chipiotembedded/ABHAY-PRODUCT/Hardware/Receiver/BOM/CPV0001_BOM.xlsx

CPV0001 - BOM
Reference | Value | Footprint | QTY | Price (1 pc) IN RS
C1 | 22uF | Capacitor_SMD:C_0805_2012Metric_Pad1.18x1.45mm_HandSolder | 1 | 1
C2, C3, C4, C6, C8, C9, C10, C11, C12, C13,C14 | 0.1uF | Capacitor_SMD:C_0603_1608Metric_Pad1.08x0.95mm_HandSolder | 11 | 0.35
C5, C7 | 10uF | Capacitor_SMD:C_0805_2012Metric_Pad1.18x1.45mm_HandSolder | 2 | 1.5
D1 | G_LED | LED_SMD:LED_0805_2012Metric_Pad1.15x1.40mm_HandSolder | 1 | 1
J1 | USB Type A Right Angle Female Connector | Connector_USB:USB_A_Molex_67643_Horizontal | 1 | 5
J2 | UFL MALE CONNECTOR SMD | ufl:HRS_U.FL-R-SMT_01_ | 1 | 10
 | 2.4 GHZ/3 DB AT 5 GHZ SMA MALE RUBBER DUCK WIFI FOLDING ANTENNA-105 MM |  | 1 | 55
 | SMA FEMALE TO UFL ANTENNA EXT -200MM |  | 1 | 35
J3 | VIN BAT (screw terminal ) | TerminalBlock:TerminalBlock_bornier-2_P5.08mm | 1 | 3
J4 | Boot Button (burgstrips ) | Connector_PinHeader_2.54mm:PinHeader_1x02_P2.54mm_Vertical | 1 | 5
J5 | I2C (Pin 2.54 mm Pitch Male Berg Strip Straight Single Row Header 15 mm Height Gold Plated) | Connector_PinHeader_2.54mm:PinHeader_1x04_P2.54mm_Vertical | 1 | 10
J6 | BUZZER (screw terminal ) | TerminalBlock:TerminalBlock_bornier-2_P5.08mm | 1 | 3
J7 | FLASHER (screw terminal ) | TerminalBlock:TerminalBlock_bornier-2_P5.08mm | 1 | 3
J8 | UART (Code_Flasher (burgstrips )) | Connector_PinSocket_2.54mm:PinSocket_1x04_P2.54mm_Vertical | 1 | 5
R1 | 0 ohm (Resistor) | Resistor_SMD:R_0805_2012Metric_Pad1.20x1.40mm_HandSolder | 1 | 0.5
R2 | 10k (Resistor) | Resistor_SMD:R_0805_2012Metric_Pad1.20x1.40mm_HandSolder | 1 | 0.5
R3 | 330E (Resistor) | Resistor_SMD:R_0805_2012Metric_Pad1.20x1.40mm_HandSolder | 1 | 0.5
SW1 | SW_Push | Button_Switch_THT:SW_PUSH_6mm_H7.3mm | 1 | 3
SW2.SW3,SW4,SW5,SW6,SW7 | NUM_1,NUM_2,UP,BACK,NEXT,SILANCE | Button_Switch_THT:SW_PUSH-12mm , 12 x 12 x 20 mm Momentary Tactile Switch 4 Pin DIP Black ROHS | 6 | 10
U1 | ESP32-S3-WROOM-1-N16R8 | esp3 s3:ESP32-S3-WROOM-1_EXP | 1 | 356
U2 | RFM95W-868S2 (lora module ) | RF_Module:Ai-Thinker-Ra-01-LoRa | 1 | 500
U3 | LM1117DT-3.3 (regulator ) | Package_TO_SOT_SMD:TO-252-3_TabPin2 | 1 | 5
Adapter | 5 v |  | 1 | 150
METAL SPACERS THREADED MS-10 | 10MM |  |  | 5
POWER Jack | 2.1x5.5mm DC Power Jack Socket Panel Mount (Female) - |  | 1 | 10
cable gland | Polyamide Cable Gland PG 9 |  | 1 | 20
Enclosure metel box with screw |  |  | 1 | 500
16X 4 LCD | 16X4 GREEN LCD JHD Make |  | 1 | 315
 |  | Manufacturing cost (PCB) |  | 1200
 |  | Total |  | 3213.35
