chipiotembedded/ABHAY-PRODUCT/Enclosure/3D_box_new_Latest.iges

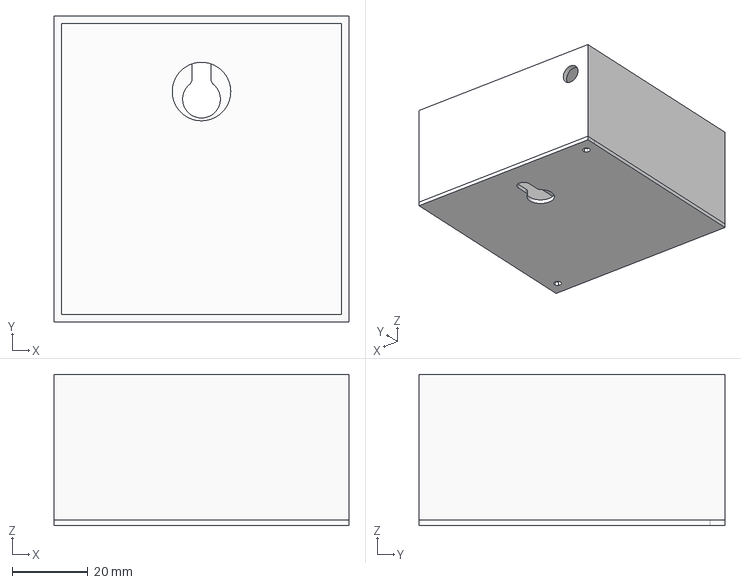
[picture p1: CAD file, 2026-10-03]
Enclosure/3D_box_new_Latest.iges
78.0 x 81.0 x 40.0 mm
