chipiotembedded/ABHAY-PRODUCT/Hardware/Receiver/kicad/reciever-.kicad_pcb

## KiCad design Hardware/Receiver/kicad/reciever-.kicad_pcb (2026-10-03)

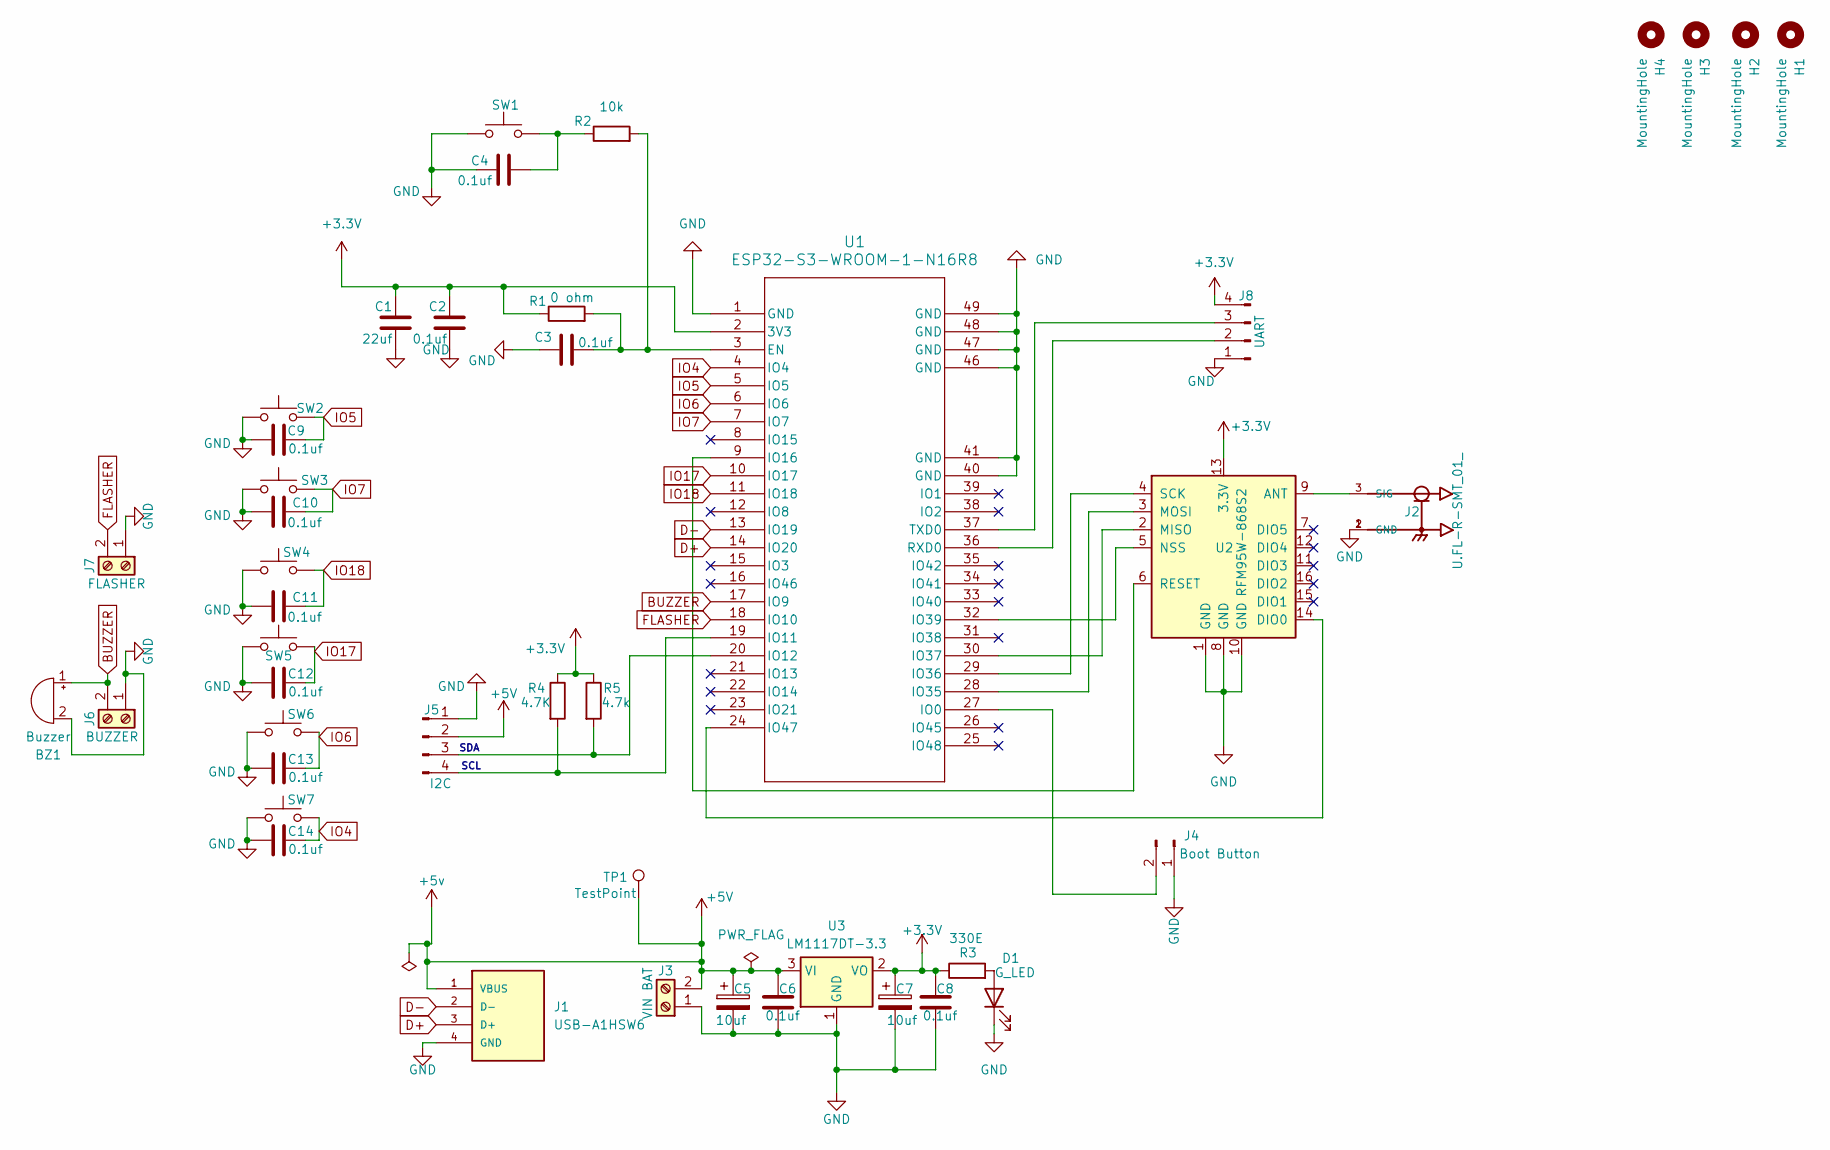
[picture p2: schematic reciever-.kicad_sch]

Parts:
BZ1: Buzzer; Buzzer_TDK_PS1240P02BT_D12.2mm_H6.5mm
C1: 22uf; C_0805_2012Metric_Pad1.18x1.45mm_HandSolder
C2, C3, C4, C6, C8, C9, C10, C11, C12, C13, C14: 0.1uf; C_0603_1608Metric_Pad1.08x0.95mm_HandSolder
C5, C7: 10uf; C_0805_2012Metric_Pad1.18x1.45mm_HandSolder
D1: G_LED; LED_0805_2012Metric_Pad1.15x1.40mm_HandSolder
H1, H2, H3, H4: MountingHole; MountingHole_3.5mm_Pad
J1: USB-A1HSW6; USB_A_Molex_67643_Horizontal
J2: U.FL-R-SMT_01_; HRS_U.FL-R-SMT_01_
J3: VIN BAT; TerminalBlock_bornier-2_P5.08mm
J4: Boot Button; PinHeader_1x02_P2.54mm_Vertical
J5: I2C; PinHeader_1x04_P2.54mm_Vertical
J6: BUZZER; TerminalBlock_bornier-2_P5.08mm
J7: FLASHER; TerminalBlock_bornier-2_P5.08mm
J8: UART; PinSocket_1x04_P2.54mm_Vertical
R1: 0 ohm; R_0805_2012Metric_Pad1.20x1.40mm_HandSolder
R2: 10k; R_0805_2012Metric_Pad1.20x1.40mm_HandSolder
R3: 330E; R_0805_2012Metric_Pad1.20x1.40mm_HandSolder
R4: 4.7K; R_0805_2012Metric
R5: 4.7k; R_0805_2012Metric
SW1: SW_Push; SW_PUSH_6mm_H7.3mm
SW2: NUM_2; SW_PUSH-12mm
SW3: UP; SW_PUSH-12mm
SW4: SILENCE; SW_PUSH-12mm
SW5: NEXT; SW_PUSH-12mm
SW6: Back/Cancle; SW_PUSH-12mm
SW7: NUM_1; SW_PUSH-12mm
TP1: TestPoint; TestPoint_Pad_D1.5mm
U1: ESP32-S3-WROOM-1-N16R8; ESP32-S3-WROOM-1_EXP
U2: RFM95W-868S2; Ai-Thinker-Ra-01-LoRa
U3: LM1117DT-3.3; TO-252-3_TabPin2

Connections:
+3.3V: C1.1, C2.1, C7.1, C8.1, J8.4, R1.1, R3.1, R4.1, R5.1, U1.2 (3V3), U2.13 (3.3V), U3.2 (VO)
+5V: C5.1, C6.1, J1.1 (VBUS), J3.2, J5.2, TP1.1, U3.3 (VI)
BUZZER: BZ1.1 (+), J6.2, U1.17 (IO9)
D+: J1.3 (D+), U1.14 (IO20)
D-: J1.2 (D-), U1.13 (IO19)
FLASHER: J7.2, U1.18 (IO10)
GND: BZ1.2 (-), C1.2, C2.2, C3.1, C4.1, C5.2, C6.2, C7.2, C8.2, C9.1, C10.1, C11.1, C12.1, C13.1, C14.1, D1.1 (K), J1.4 (GND), J2.1 (GND), J2.2 (GND), J3.1, J4.1, J5.1, J6.1, J7.1, J8.1, SW1.1, SW2.1, SW3.1, SW4.1, SW5.1, SW6.1, SW7.1, U1.1 (GND), U1.40 (GND), U1.41 (GND), U1.42, U1.43, U1.44, U1.45, U1.46 (GND), U1.47 (GND), U1.48 (GND), U1.49 (GND), U2.1 (GND), U2.8 (GND), U2.10 (GND), U3.1 (GND); also elsewhere on the board
IO4: C14.2, SW7.2, U1.4 (IO4)
IO5: C9.2, SW2.2, U1.5 (IO5)
IO6: C13.2, SW6.2, U1.6 (IO6)
IO7: C10.2, SW3.2, U1.7 (IO7)
IO17: C12.2, SW5.2, U1.10 (IO17)
IO18: C11.2, SW4.2, U1.11 (IO18)
unnamed: C4.2, R2.1, SW1.2
unnamed: D1.2 (A), R3.2
unnamed: J2.3 (SIG), U2.9 (ANT)
unnamed: J4.2, U1.27 (IO0)
unnamed: J5.3, R5.2, U1.20 (IO12)
unnamed: J5.4, R4.2, U1.19 (IO11)
unnamed: J8.2, U1.36 (RXD0)
unnamed: J8.3, U1.37 (TXD0)
unnamed: C3.2, R1.2, R2.2, U1.3 (EN)
unnamed: U1.9 (IO16), U2.6 (RESET)
unnamed: U1.28 (IO35), U2.3 (MOSI)
unnamed: U1.29 (IO36), U2.4 (SCK)
unnamed: U1.30 (IO37), U2.2 (MISO)
unnamed: U1.32 (IO39), U2.5 (NSS)
unnamed: U1.24 (IO47), U2.14 (DIO0)

Notes on the sheet:
SDA
SCL

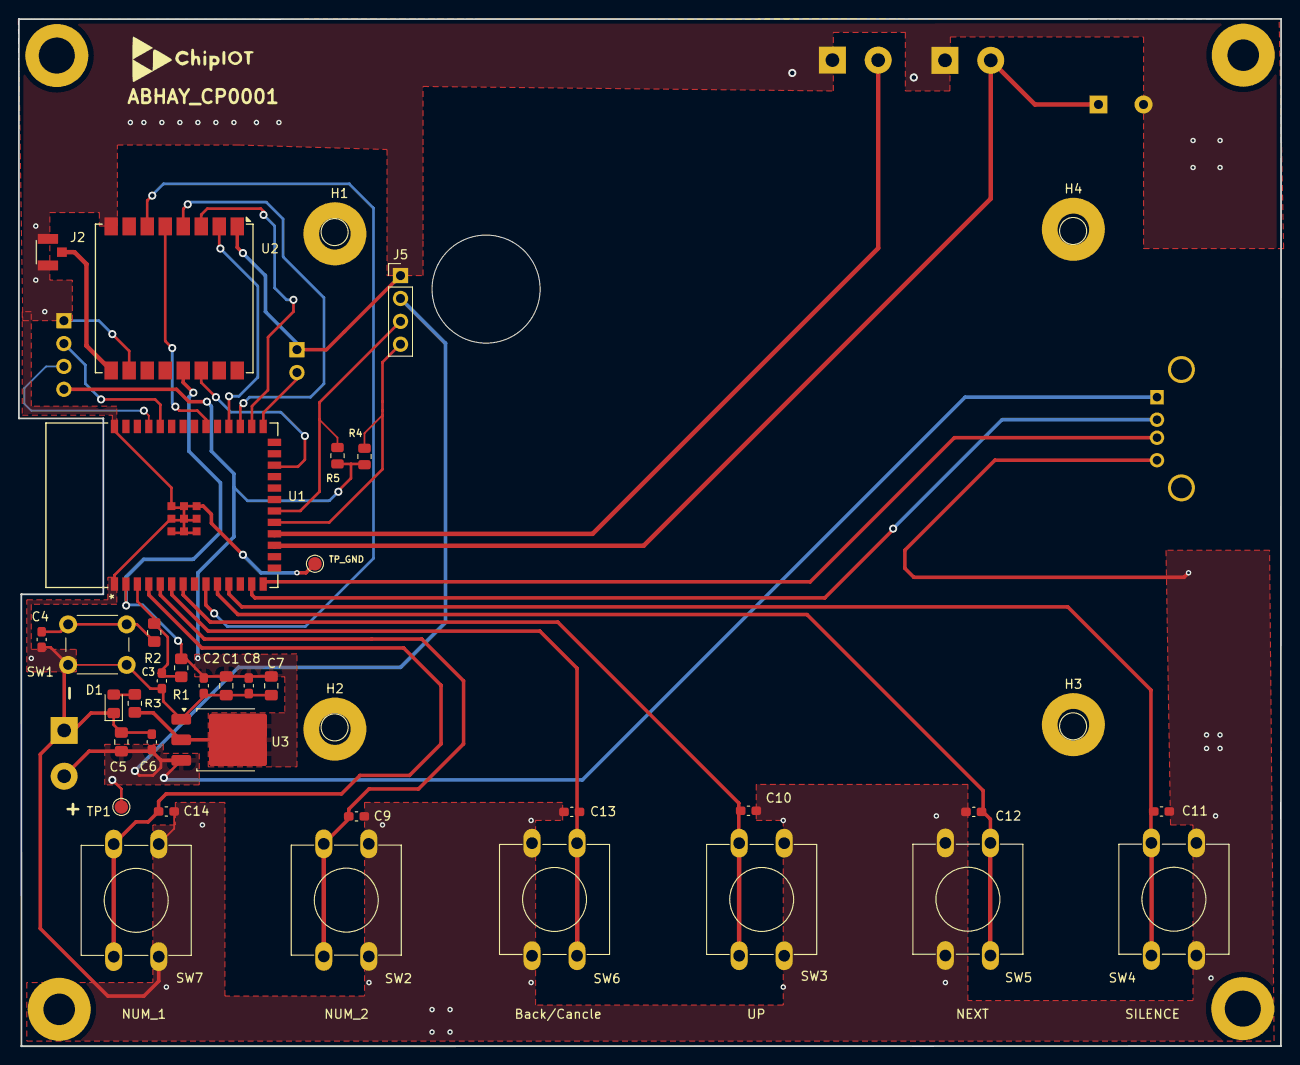
[picture p3: board reciever-.kicad_pcb from above]

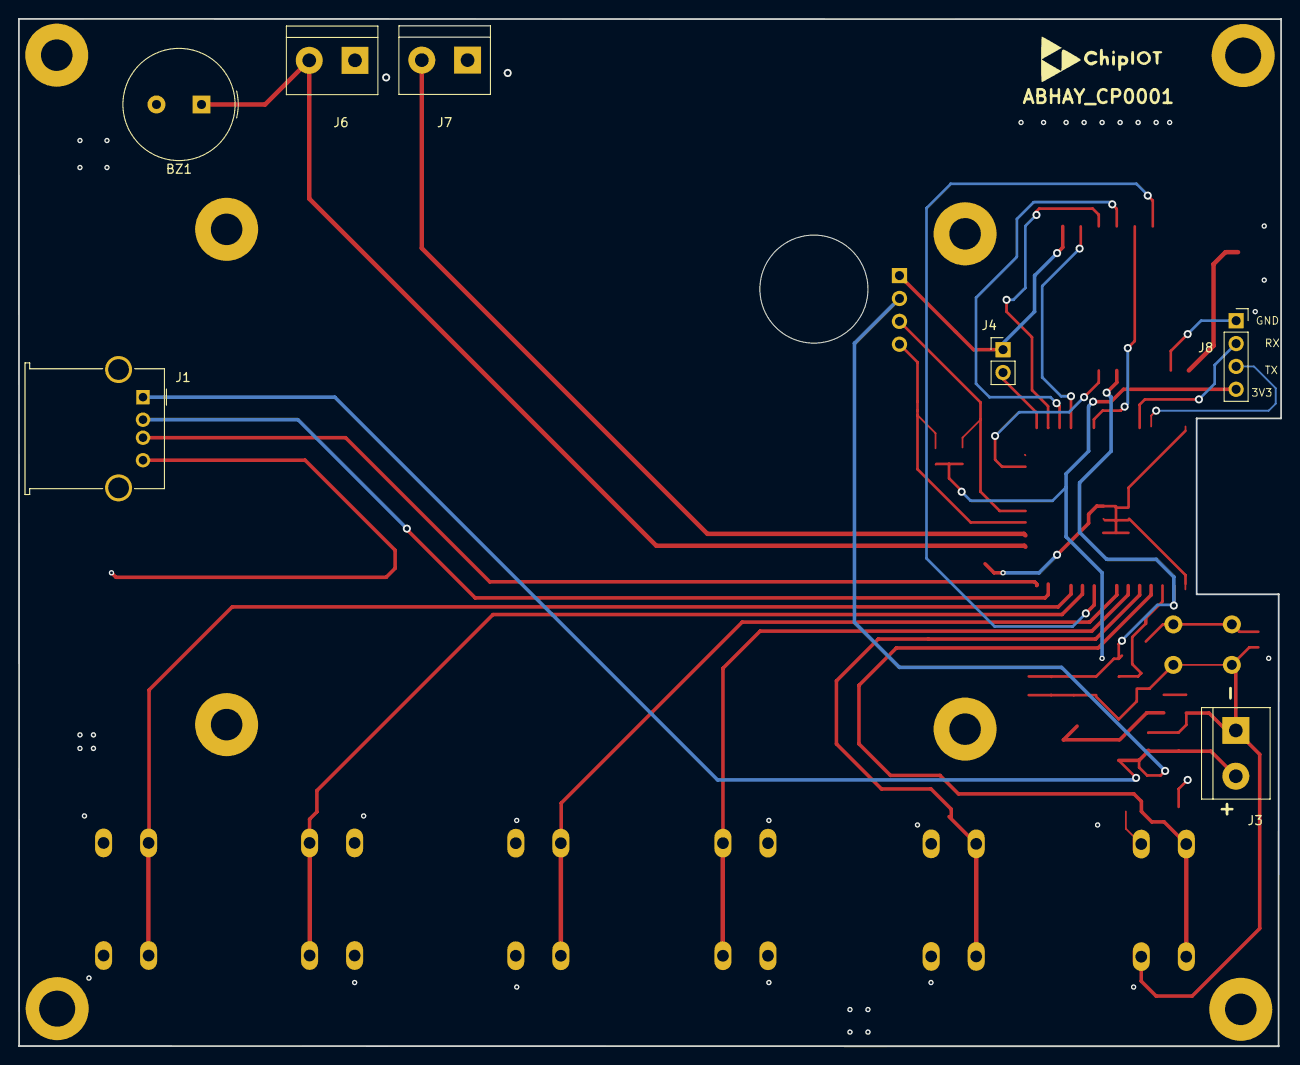
[picture p4: board reciever-.kicad_pcb from below]

Board: 2 copper layers, 140.2 x 114.1 mm, 45 parts (7 on the bottom side), 28 nets.

Other parts of the board:
TP_GND: TestPoint_Pad_D1.5mm

Their connections:
GND: TP_GND.1; also elsewhere on the board
