chipiotembedded/ABHAY-PRODUCT/Hardware/Sender/Kicad/EPV0001.kicad_pcb

## KiCad design Hardware/Sender/Kicad/EPV0001.kicad_pcb (2026-10-03)

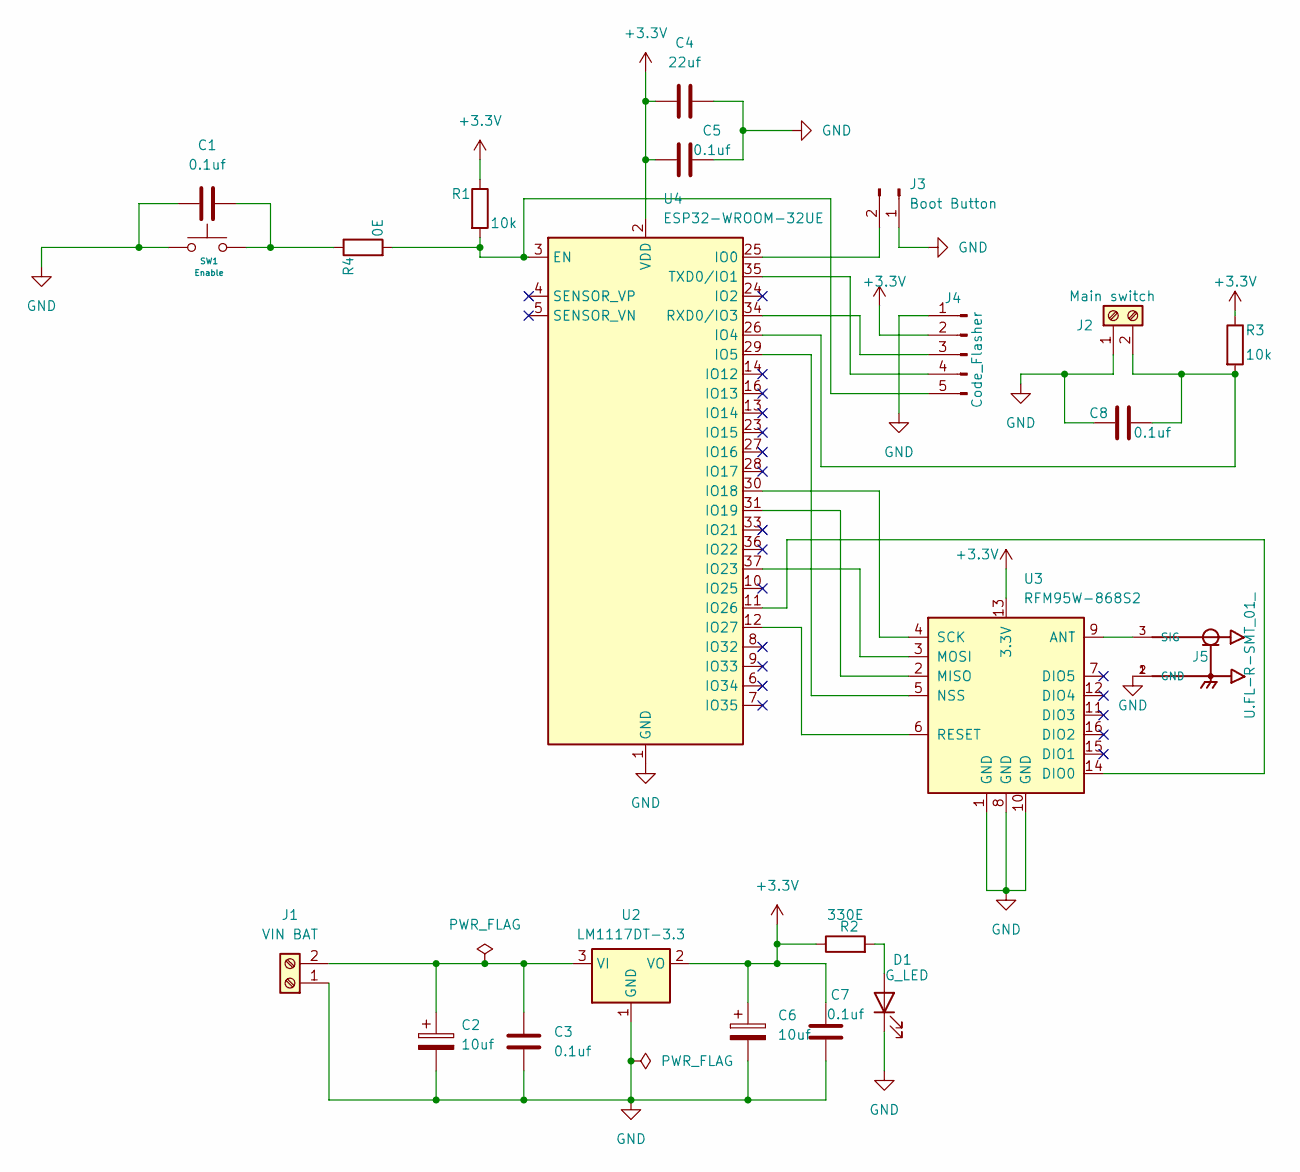
[picture p5: schematic EPV0001.kicad_sch]

Parts:
C1, C3, C5, C7, C8: 0.1uf; C_0805_2012Metric
C2, C6: 10uf; C_0805_2012Metric
C4: 22uf; C_0805_2012Metric
D1: G_LED; LED_0805_2012Metric_Pad1.15x1.40mm_HandSolder
J1: VIN BAT; TerminalBlock_bornier-2_P5.08mm
J2: Main switch; TerminalBlock_bornier-2_P5.08mm
J3: Boot Button; PinHeader_1x02_P2.54mm_Vertical
J4: Code_Flasher; PinHeader_1x05_P2.54mm_Vertical
J5: U.FL-R-SMT_01_; u3
R1, R3: 10k; R_0805_2012Metric
R2: 330E; R_0805_2012Metric_Pad1.20x1.40mm_HandSolder
R4: 0E; R_0805_2012Metric
SW1: Enable; SW4_1825910-D_TEC
U2: LM1117DT-3.3; TO-252-3_TabPin2
U3: RFM95W-868S2; HOPERF_RFM9XW_SMD
U4: ESP32-WROOM-32UE

Connections:
+3.3V: C4.1, C5.1, C6.1, C7.1, J4.2, R1.1, R2.1, R3.1, U2.2 (VO), U3.13 (3.3V), U4.2 (VDD)
GND: C1.1, C2.2, C3.2, C4.2, C5.2, C6.2, C7.2, C8.1, D1.1 (K), J1.1, J2.1, J3.1, J4.1, J5.1 (GND), J5.2 (GND), SW1.1, U2.1 (GND), U3.1 (GND), U3.8 (GND), U3.10 (GND), U4.1 (GND), U4.15 (GND), U4.38 (GND), U4.39 (GND)
unnamed: C1.2, R4.1, SW1.2
unnamed: D1.2 (A), R2.2
unnamed: C2.1, C3.1, J1.2, U2.3 (VI)
unnamed: C8.2, J2.2, R3.2, U4.26 (IO4)
unnamed: J3.2, U4.25 (IO0)
unnamed: J4.3, U4.34 (RXD0/IO3)
unnamed: J4.4, U4.35 (TXD0/IO1)
unnamed: J4.5, R1.2, R4.2, U4.3 (EN)
unnamed: J5.3 (SIG), U3.9 (ANT)
unnamed: U3.14 (DIO0), U4.11 (IO26)
unnamed: U3.2 (MISO), U4.31 (IO19)
unnamed: U3.3 (MOSI), U4.37 (IO23)
unnamed: U3.5 (NSS), U4.29 (IO5)
unnamed: U3.6 (RESET), U4.12 (IO27)
unnamed: U3.4 (SCK), U4.30 (IO18)

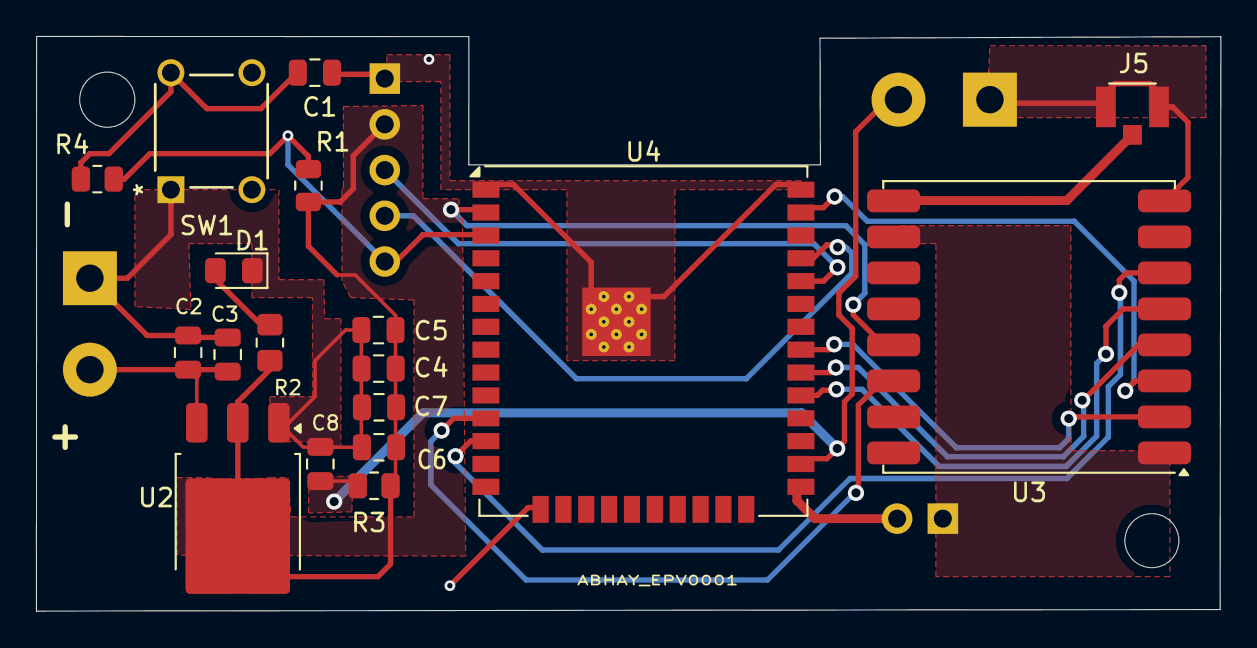
[picture p6: board EPV0001.kicad_pcb from above]

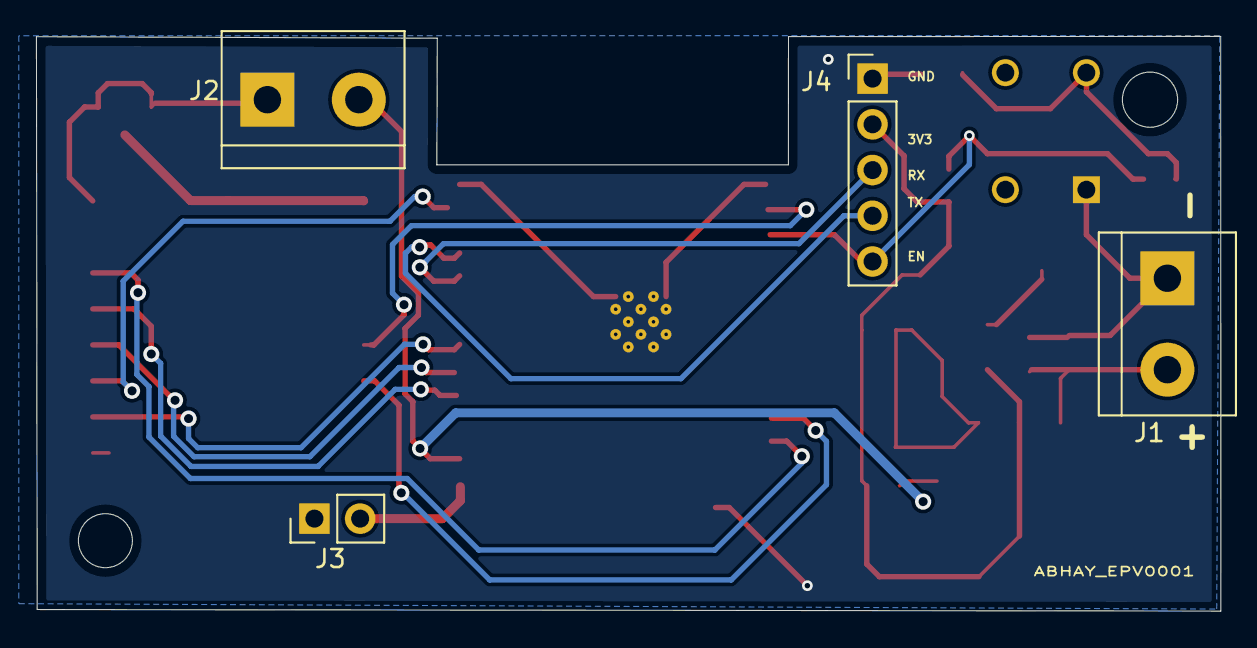
[picture p7: board EPV0001.kicad_pcb from below]

Board: 2 copper layers, 65.8 x 31.9 mm, 22 parts (4 on the bottom side), 17 nets.
